gotlaufs/rtu-nixie-clock/Pics/izstade_skola_2018.jpg

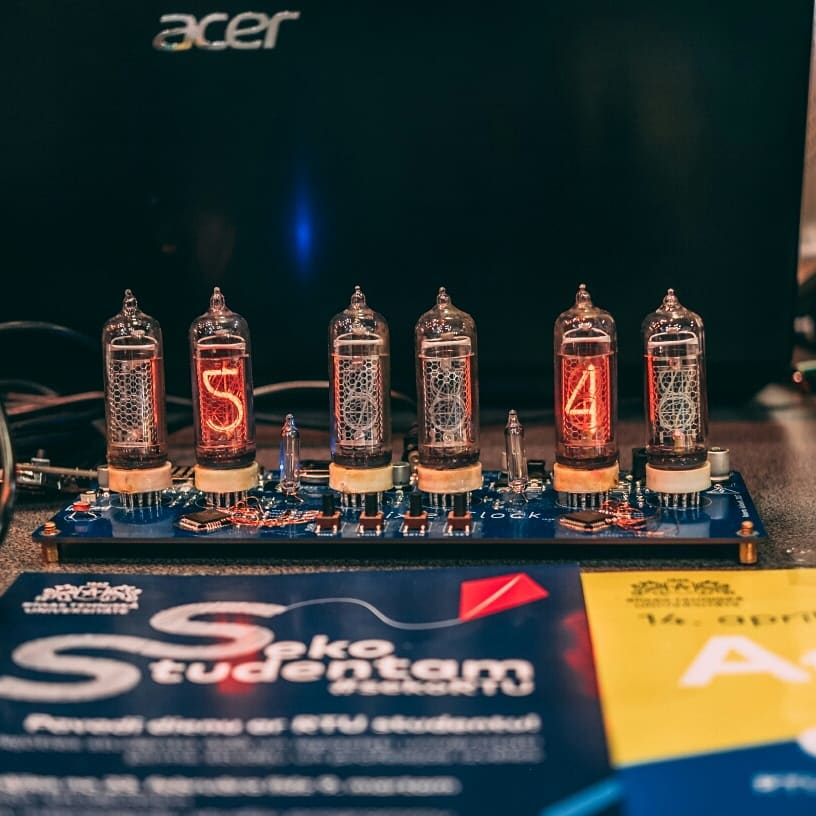
Pics/izstade_skola_2018.jpg
