gotlaufs/rtu-nixie-clock/Software/old/README

This was made using bare ESP8266 NONOS SDK and custom makefile.
