gotlaufs/rtu-nixie-clock/PCB/datasheets/SW_SMD.png

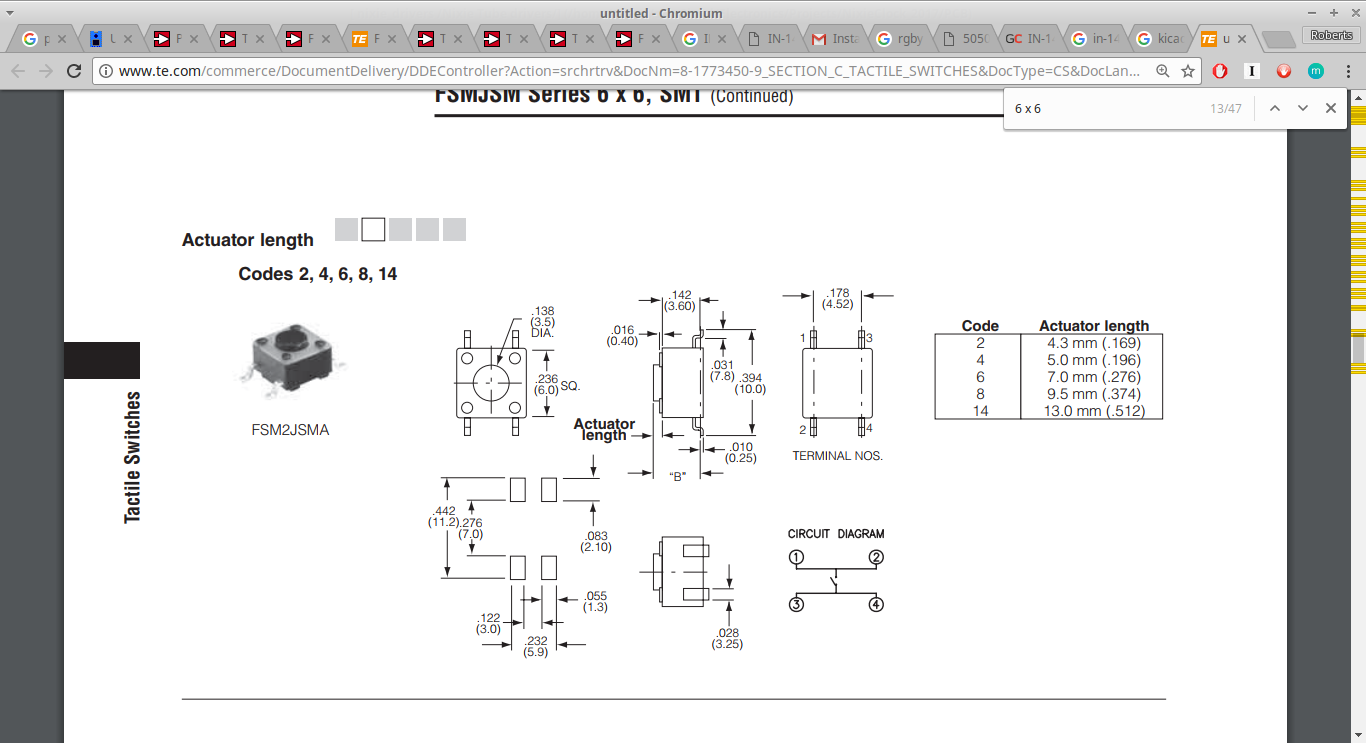
PCB/datasheets/SW_SMD.png
