gotlaufs/rtu-nixie-clock/PCB/datasheets/SW_SMD_2.jpg

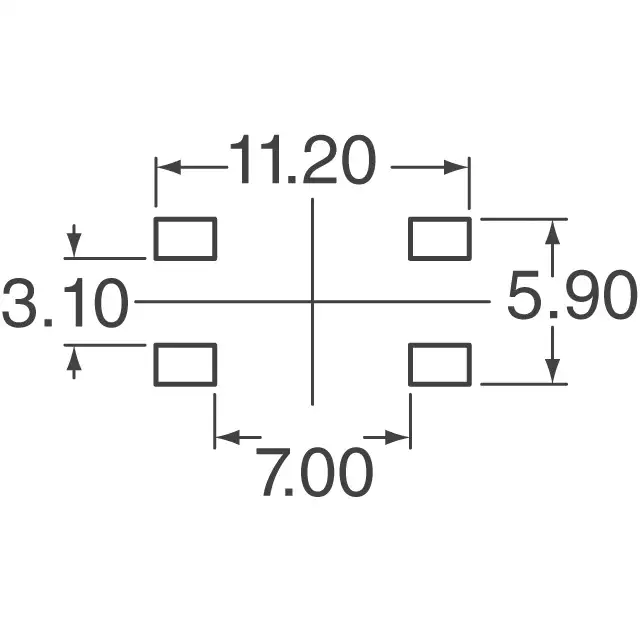
PCB/datasheets/SW_SMD_2.jpg
