gotlaufs/rtu-nixie-clock/Pics/layout/Layout_Before_GND_stiching.png

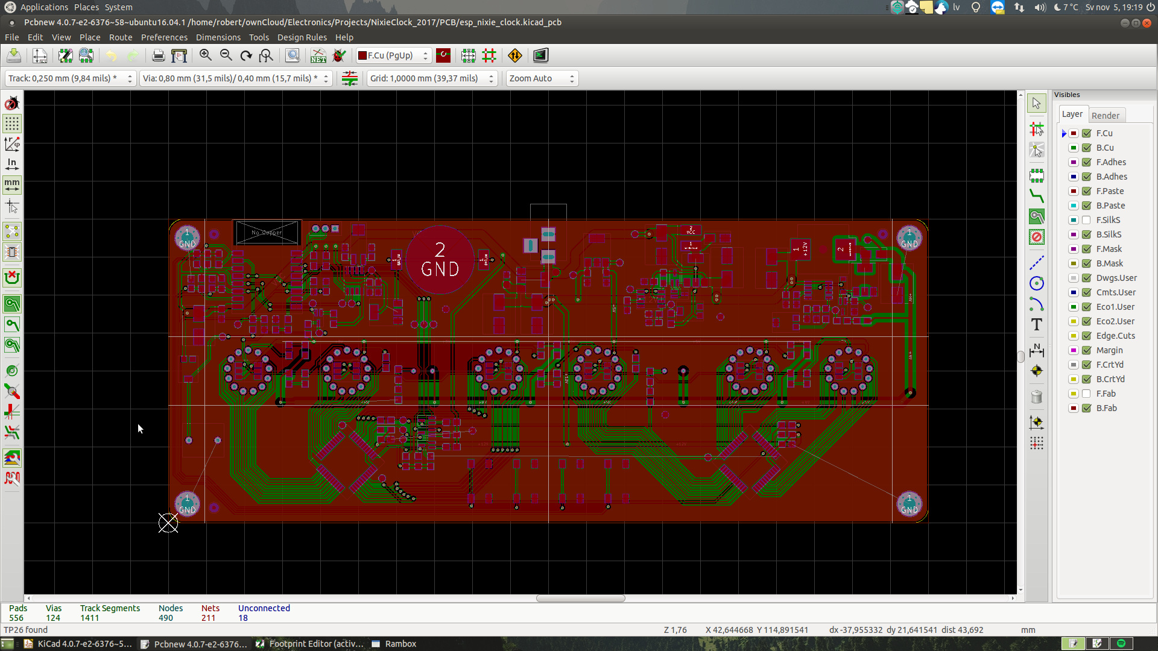
Pics/layout/Layout_Before_GND_stiching.png
