gotlaufs/rtu-nixie-clock/Pics/layout/Routing_PinSwapping_fixed.png

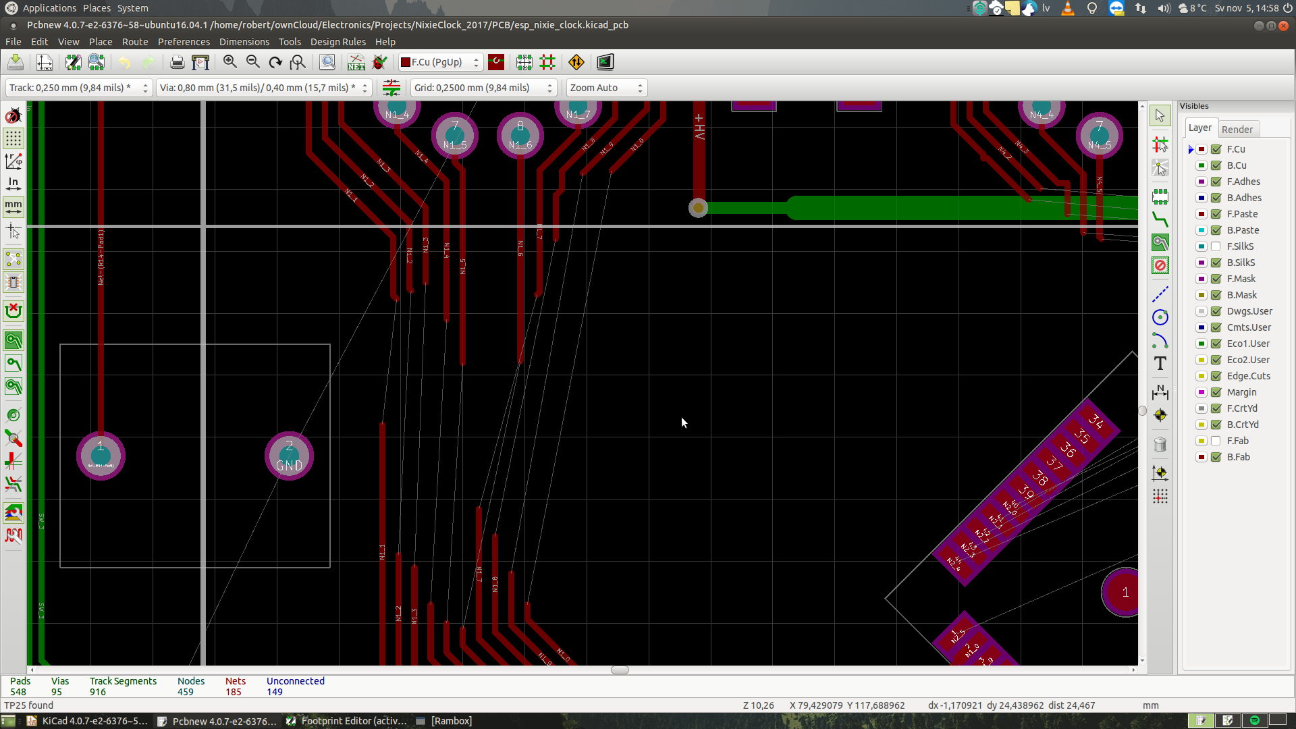
Pics/layout/Routing_PinSwapping_fixed.png
