gotlaufs/rtu-nixie-clock/Pics/layout/Routing_PinSwapping_PCB.png

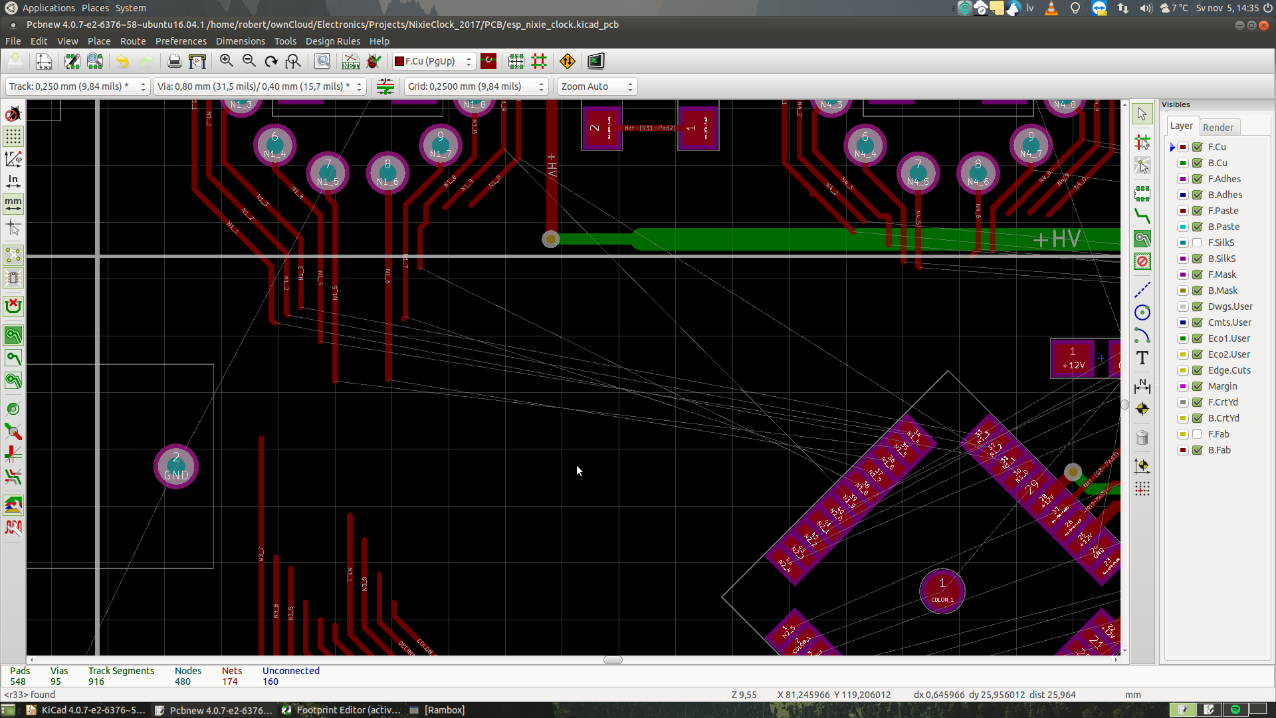
Pics/layout/Routing_PinSwapping_PCB.png
