gotlaufs/rtu-nixie-clock/Pics/layout/Routing_PinSwapping_Schematic.png

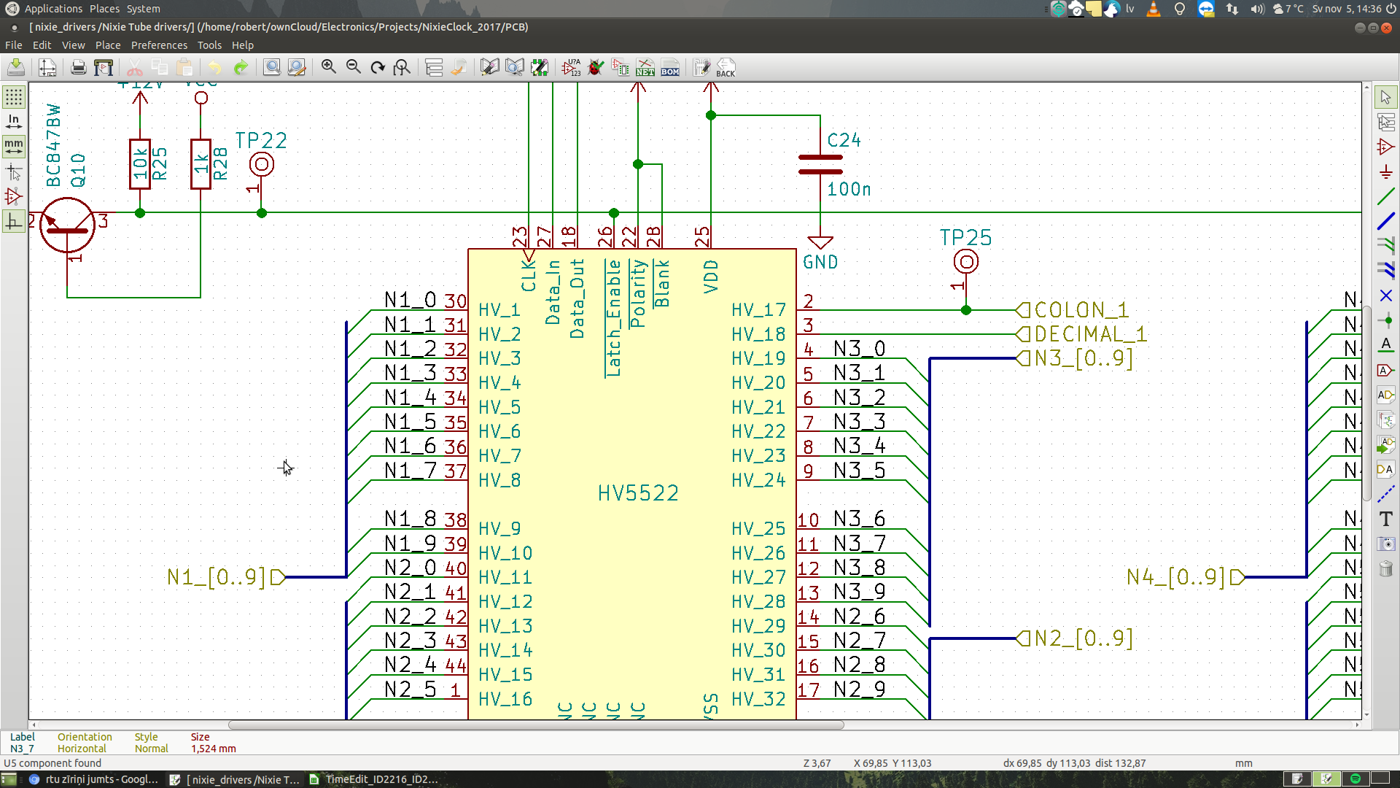
Pics/layout/Routing_PinSwapping_Schematic.png
