gotlaufs/rtu-nixie-clock/Order_2017_11_21.ods

Project | Part description | Name | Digi-key part number | Quantity | Notes
kZPD | Triac | L4004L5TP | F7224-ND | 2
 | Triac driver | MOC3021S | 160-1375-5-ND | 2
 | Optocoupler | H11AA1SM | H11AA1SM-ND | 2
 | Resistor | Res 2010 7.5k | RHM7.5KBGCT-ND | 10
 | Female header | Preci-Dip 310-87-110-41-001101 | 1212-1099-ND | 10
 | PC cable socket | Qualtek 703W-00/04 | Q212-ND | 2
 | MSP430 | MSP430G2230 | 296-30235-1-ND | 2
LED_SB | MSP430 | MSP430G2553 | 296-28430-1-ND | 2
 | Rotary Encoder | Bourns Inc. PEC11R-4225F-S0024 | PEC11R-4225F-S0024-ND | 8
NCK | HV serial to parallel converter | HV5522 | Mouser: 689-HV5522PG-G | 2 | Mouser catalog
 | 5V LDO | AZ1117-5.0 | AZ1117IH-5.0TRG1DICT-ND | 5
 | RTC | MCP7940 RTC | MCP7940NT-I/SNCT-ND | 5
 | Switching voltage regulator | MC34063 | MC34063ADGOS-ND | 5
 | Inductor | L 120 uH | SRN6045TA-121M | 1
 | Crystal | Y 32.768 kHz | CMR200T32768DZBT | 5
 | Power Jack | Power Jack | CP-002B-ND | 1
 | Neon Lamp | A1A | A1A-ND | 4
 | Tactile switch | FSMJSMA | 450-2047-1-ND | 4
 | Trimmer pot | 100k | 987-1013-1-ND | 3
 | Rectifier diode | RS1GTR | 1655-1500-1-ND | 1
 | Rectifier Diode | SS13 R3G | SS13 R3GCT-ND | 1
 | PMOS | NTF5P03T3G | NTF5P03T3GOSCT-ND | 3
 | NMOS | IPN70R900P7SATMA1 | IPN70R900P7SATMA1CT-ND | 1
 | Battery Holder | Linx Technologies Inc. BAT-HLD-001 | BAT-HLD-001-ND | 1
 | Photo resistor | CdS 200k | 1528-2141-ND | 1
 | Cap | 270p | 1276-2494-1-ND | 10
 | Cap | 6p | 1276-1767-1-ND | 10
 | Cap | 680p | 311-1126-1-ND | 10
 | Cap | 10n | 1276-1015-1-ND | 10
 | Cap | 220u | 565-4320-1-ND | 10
 | Resistor | 0R | 311-0.0ARCT-ND | 10
 | Resistor | 5.6k | RMCF0805JT5K60CT-ND | 10
 | Resistor | 3.3k | RMCF0805JT3K30CT-ND | 10
 | Resistor | 10k | RMCF0805JT10K0CT-ND | 20
 | Resistor | 165k | 311-165KCRCT-ND | 10
 | Resistor | 300R | RMCF0805JT300RCT-ND | 10
 | Resistor | 330k | RMCF0805JT330KCT-ND | 10
 | Resistor | 100k | RMCF0805JT100KCT-ND | 10
 | Resistor | 5k | RMCF0805JT5K10CT-ND | 20
 | Resistor | 68k | RMCF0805JT68K0CT-ND | 10
