gotlaufs/rtu-nixie-clock/(threads)

Thread 5 (2019-02-19):

External RTC IC crystal oscillator must be trimmed

gotlaufs, 2019-02-19:
Currently it is a bit too fast and the clock gains a few seconds every hour.
