gotlaufs/rtu-nixie-clock/Documents/nixie_schema.pdf

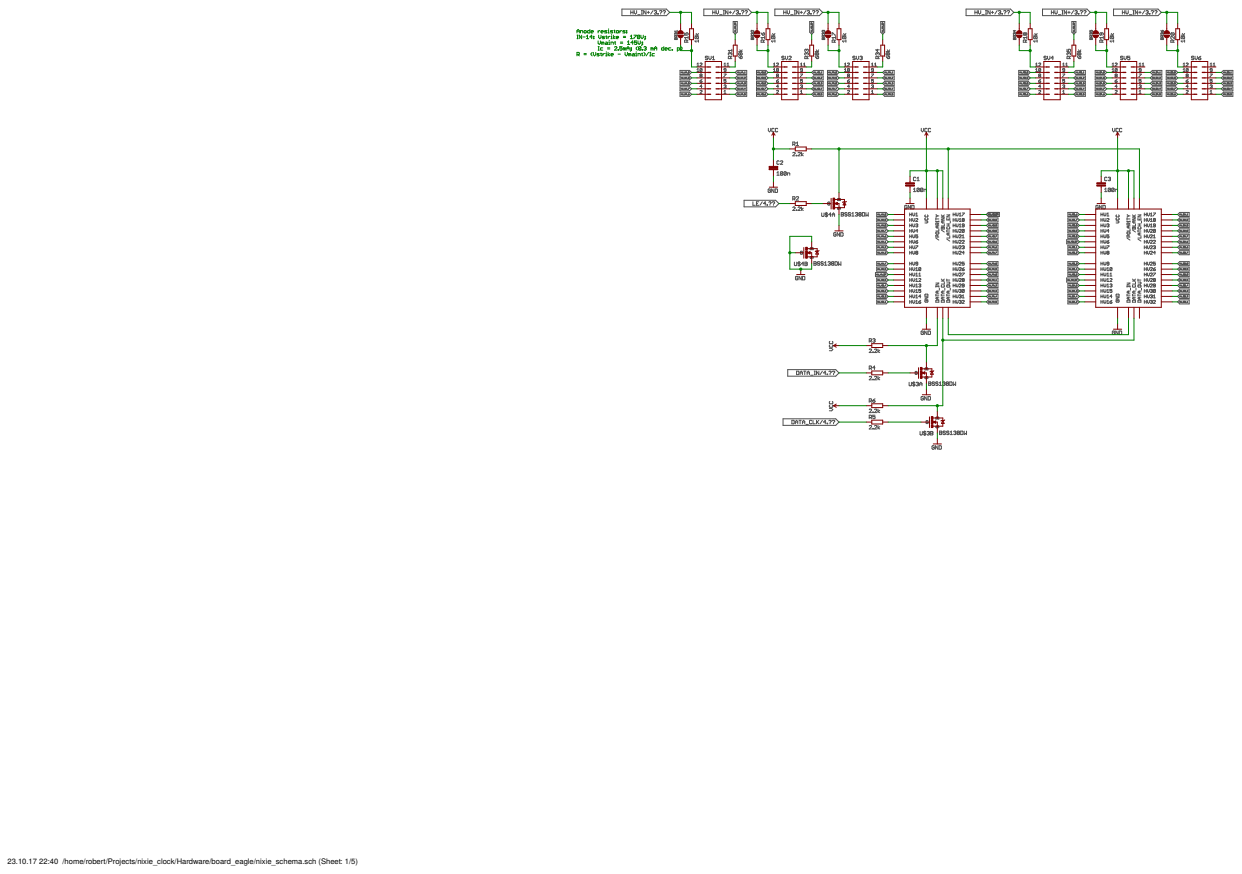
[picture p19: page 1]

23.10.17 22:40 /home/robert/Projects/nixie_clock/Hardware/board_eagle/nixie_schema.sch (Sheet: 1/5)

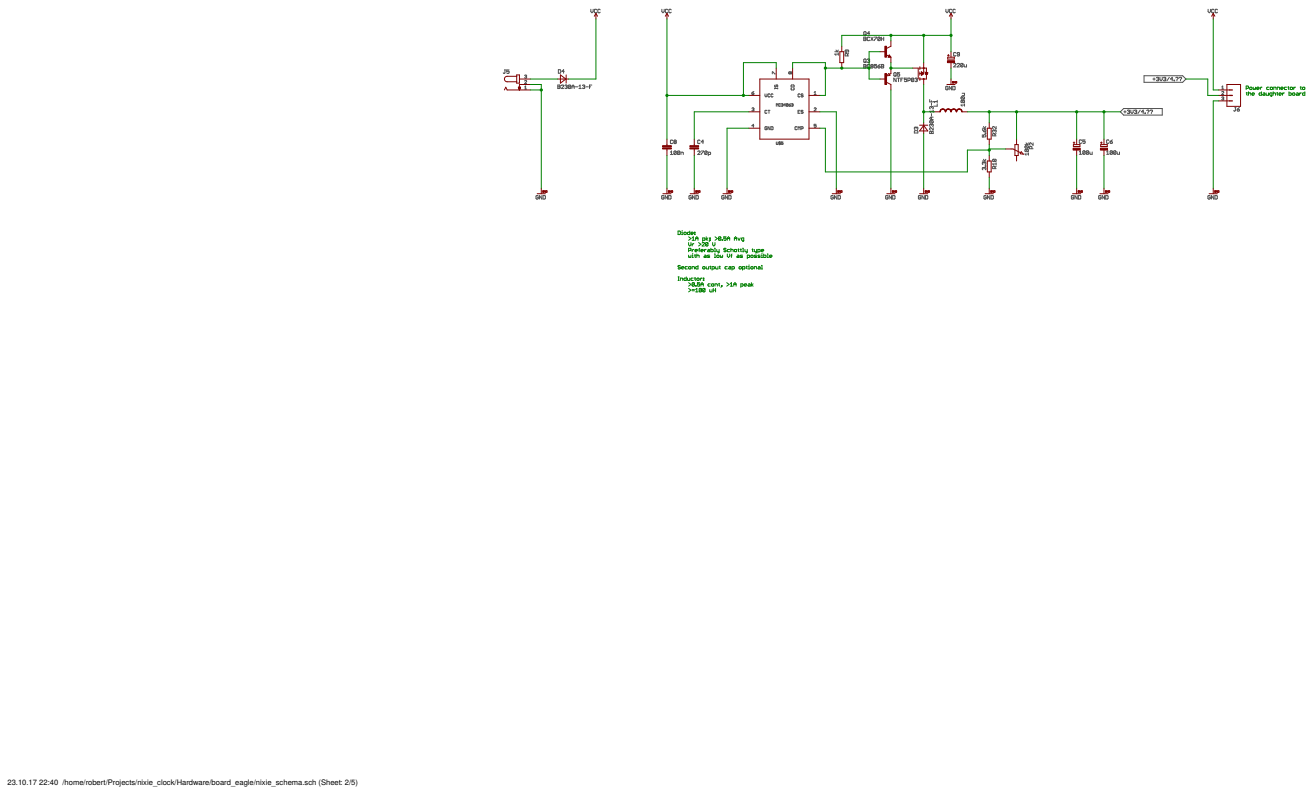
[picture p20: page 2]

23.10.17 22:40 /home/robert/Projects/nixie_clock/Hardware/board_eagle/nixie_schema.sch (Sheet: 2/5)

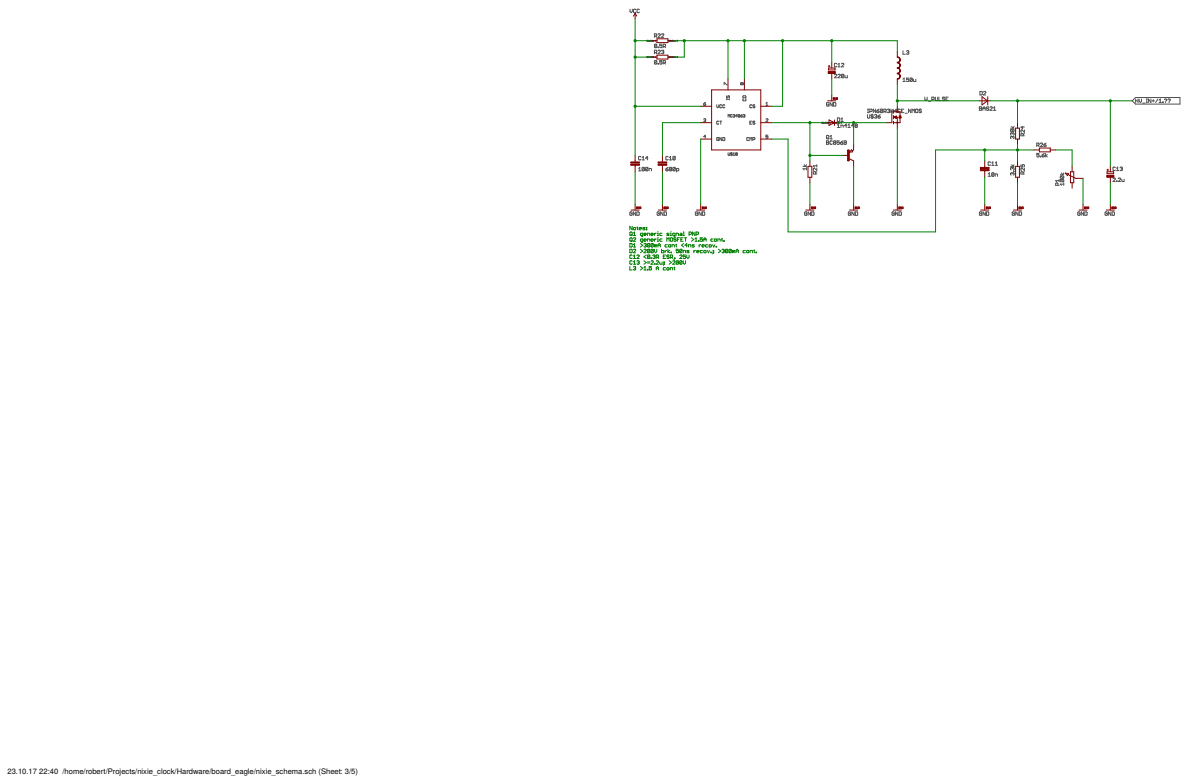
[picture p21: page 3]

23.10.17 22:40 /home/robert/Projects/nixie_clock/Hardware/board_eagle/nixie_schema.sch (Sheet: 3/5)

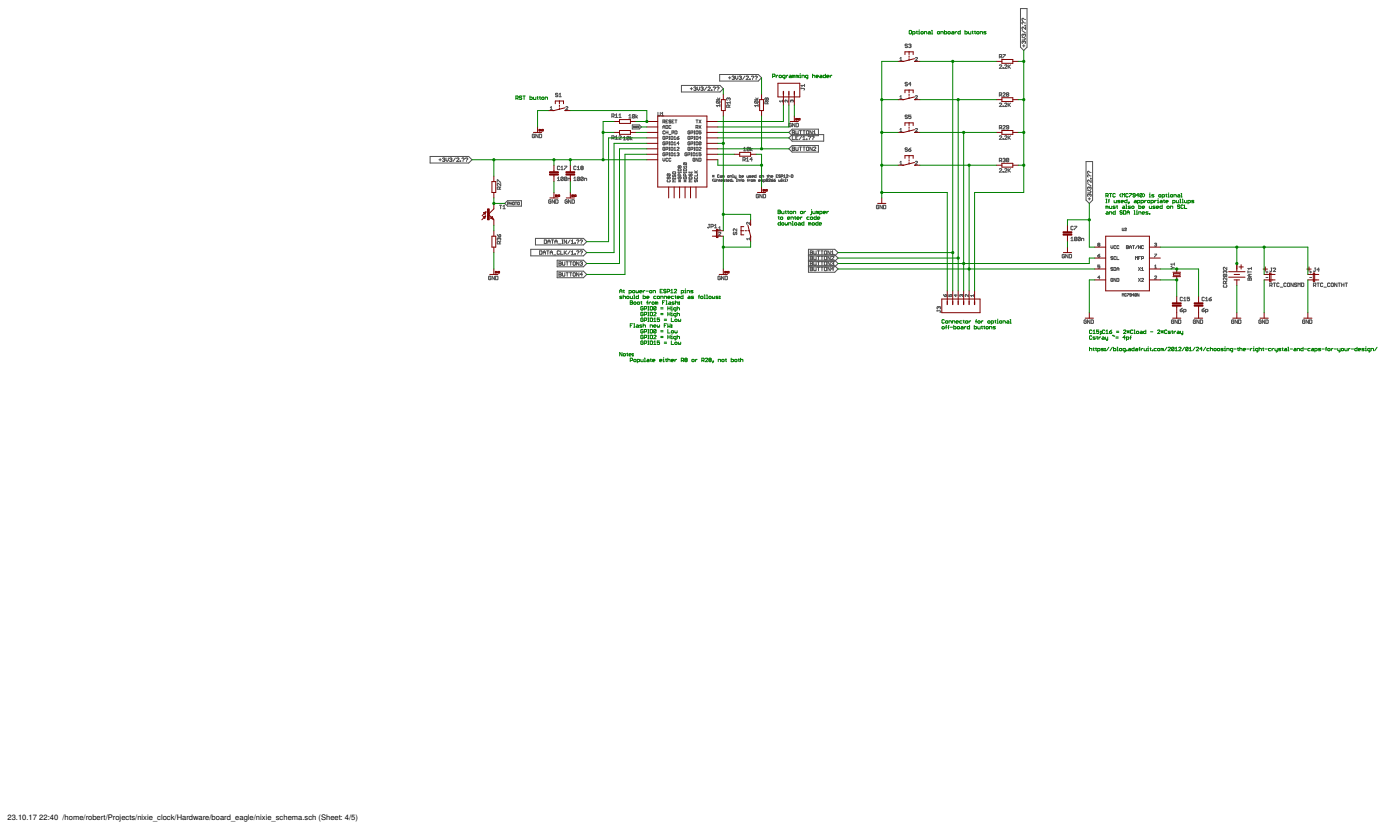
[picture p22: page 4]

23.10.17 22:40 /home/robert/Projects/nixie_clock/Hardware/board_eagle/nixie_schema.sch (Sheet: 4/5)

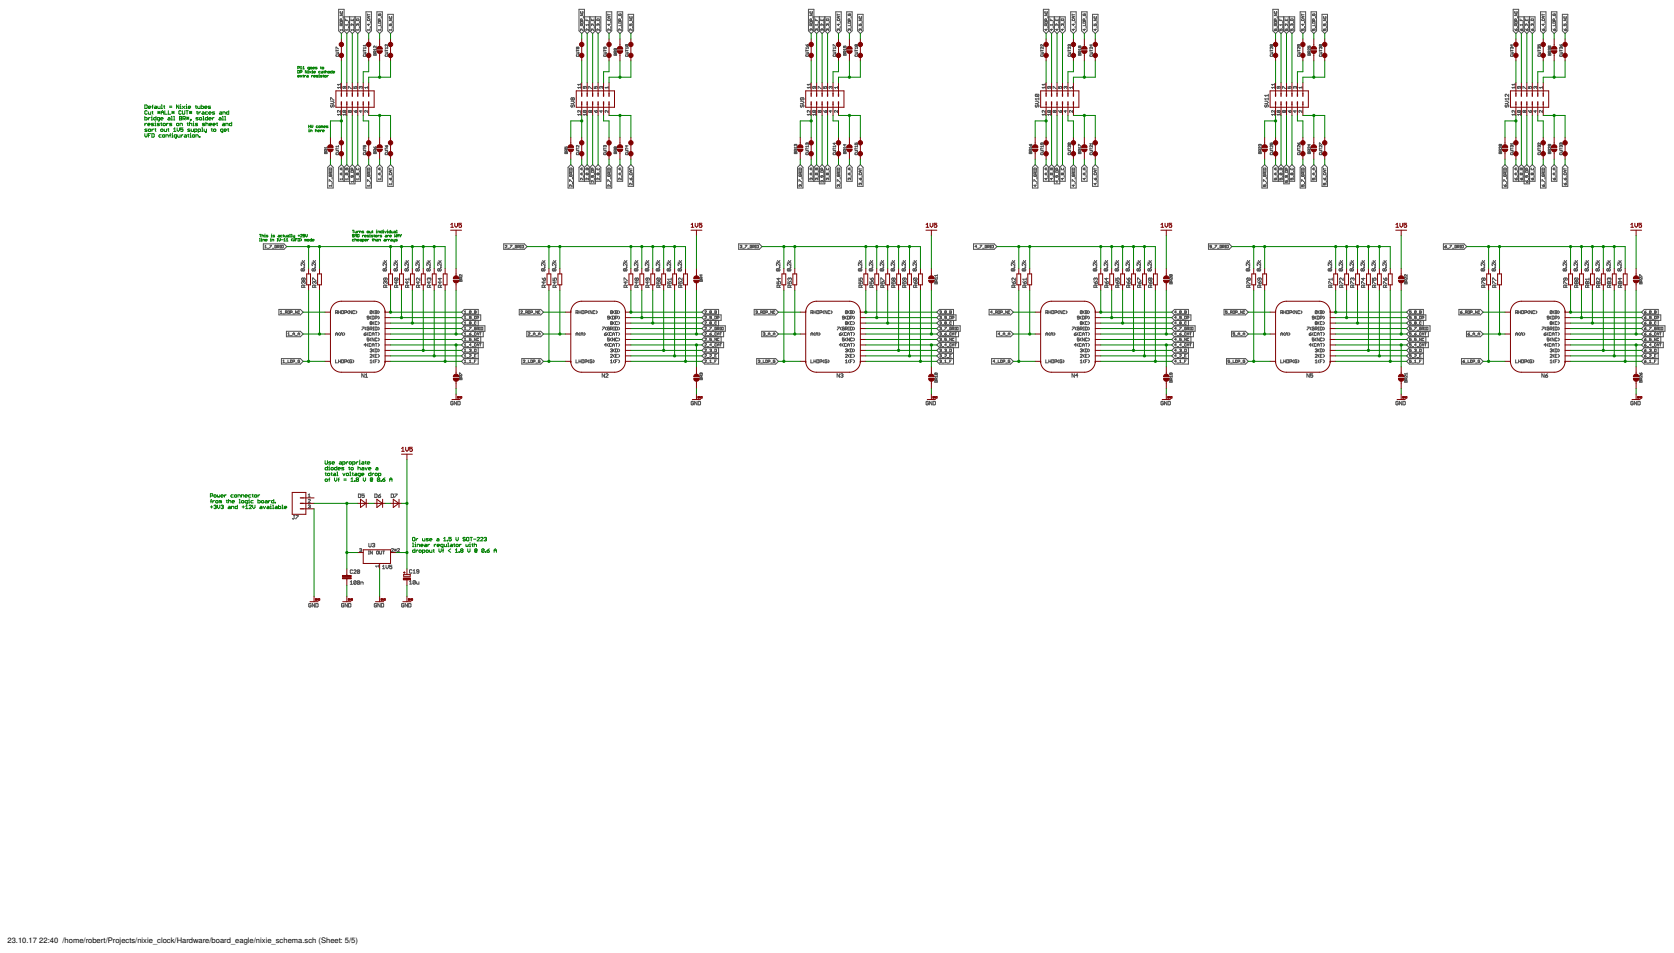
[picture p23: page 5]

23.10.17 22:40 /home/robert/Projects/nixie_clock/Hardware/board_eagle/nixie_schema.sch (Sheet: 5/5)
