gotlaufs/rtu-nixie-clock/PCB/PDF/esp_nixie_clock.pdf

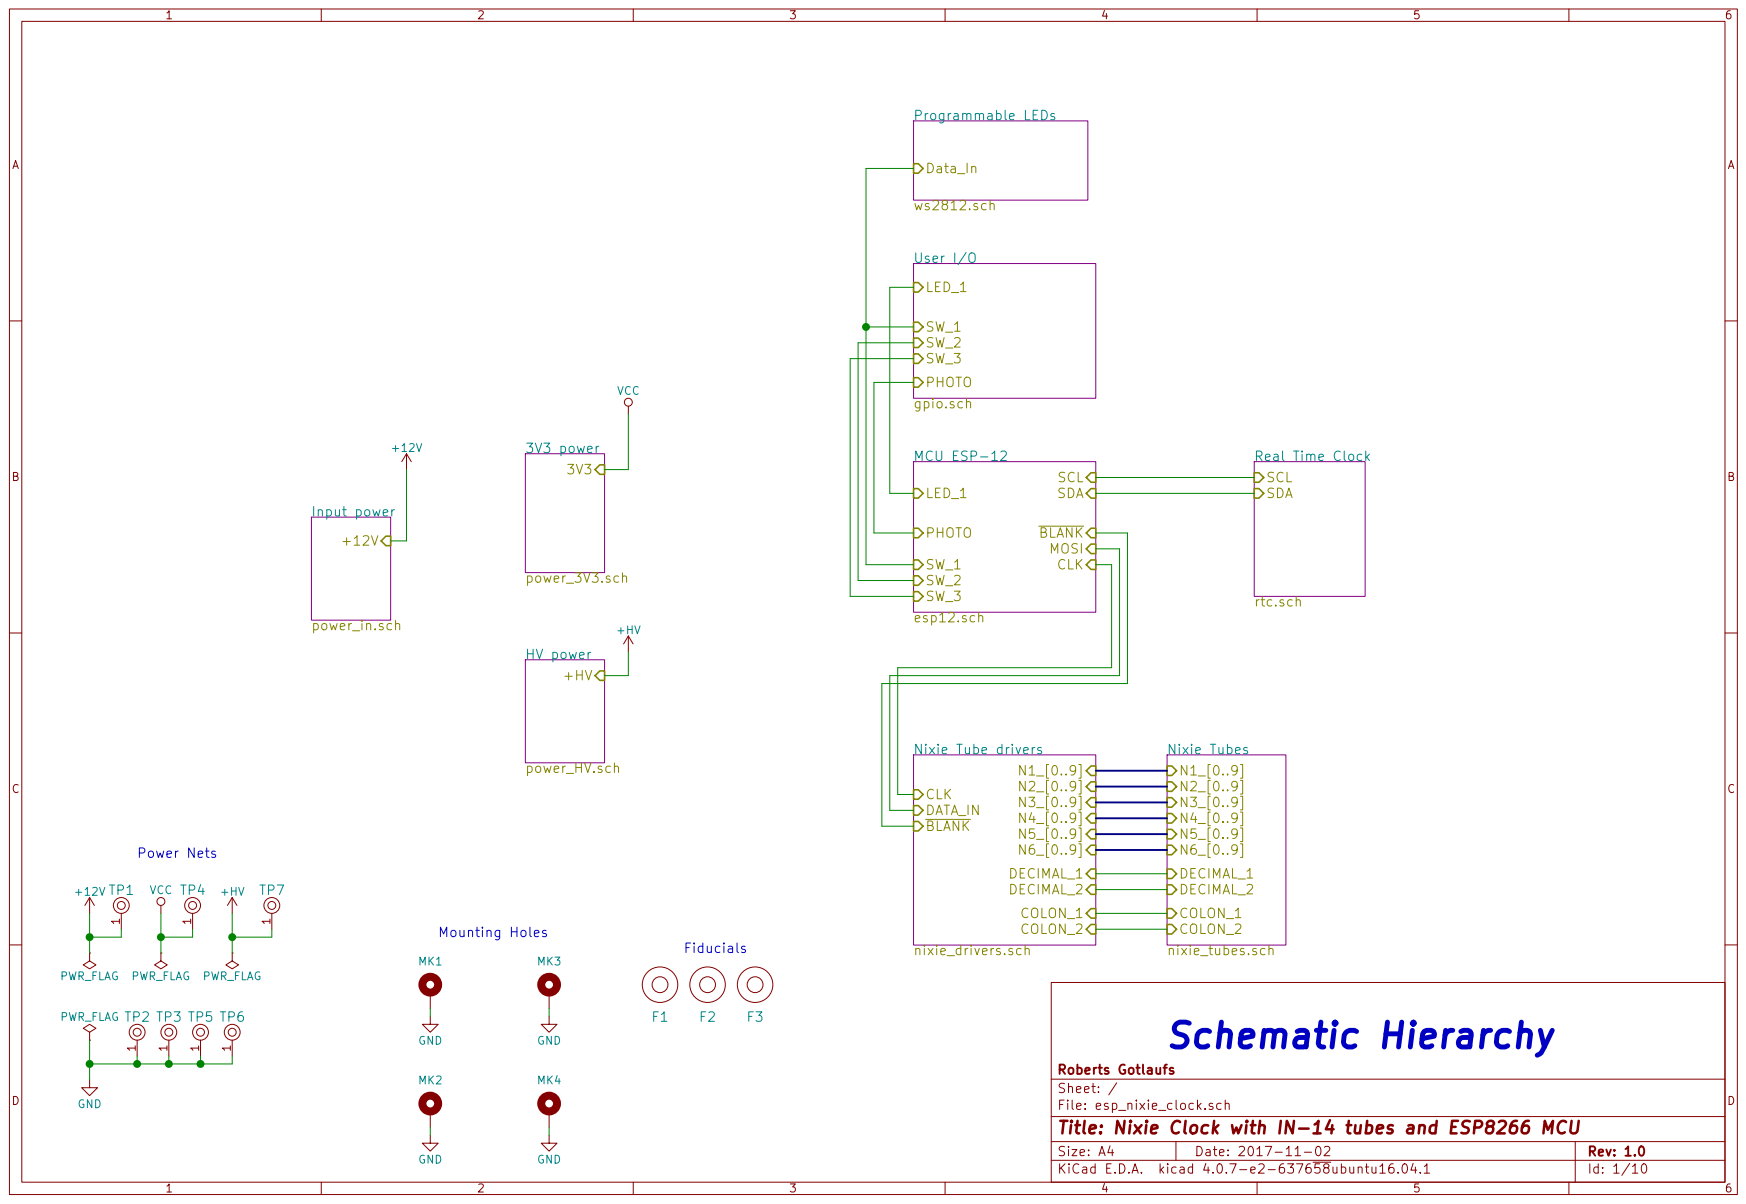
[picture p24: page 1]

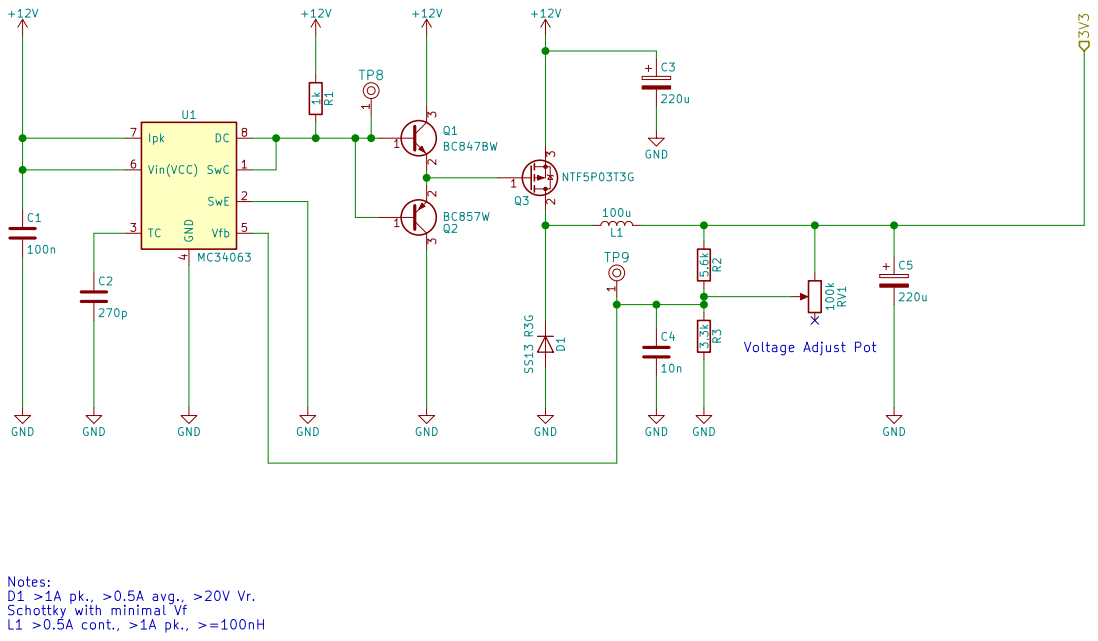
[picture p25: page 2]

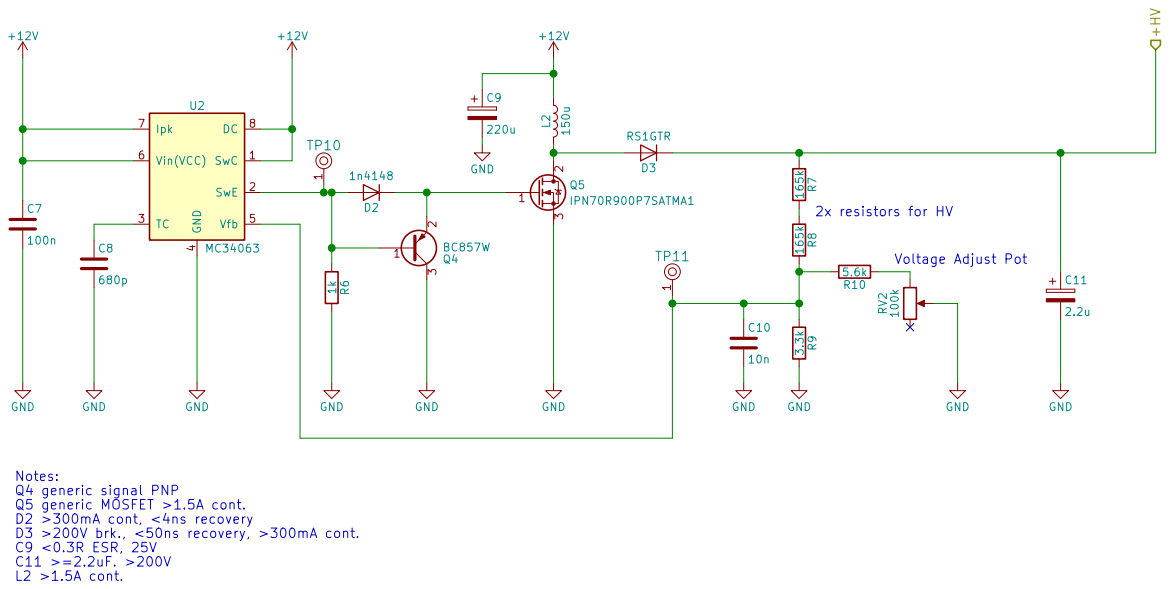
[picture p26: page 3]

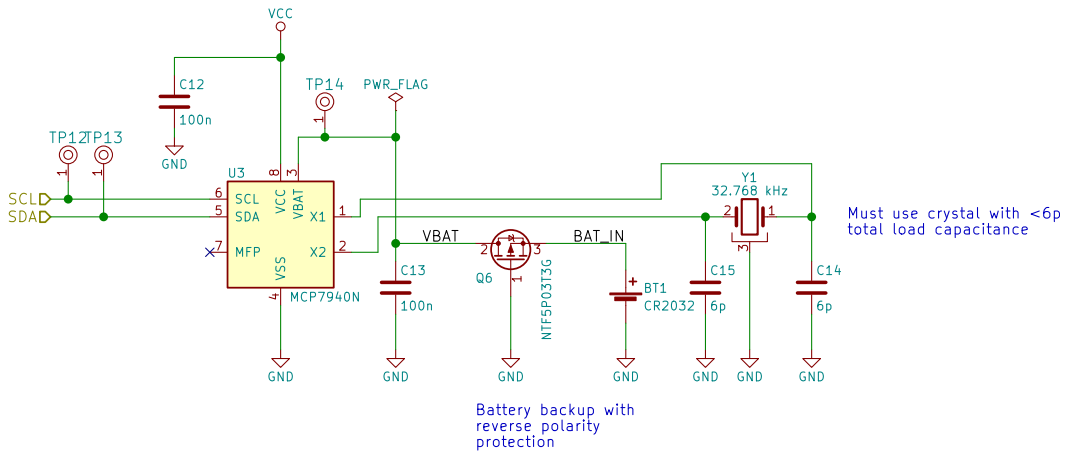
[picture p27: page 4]

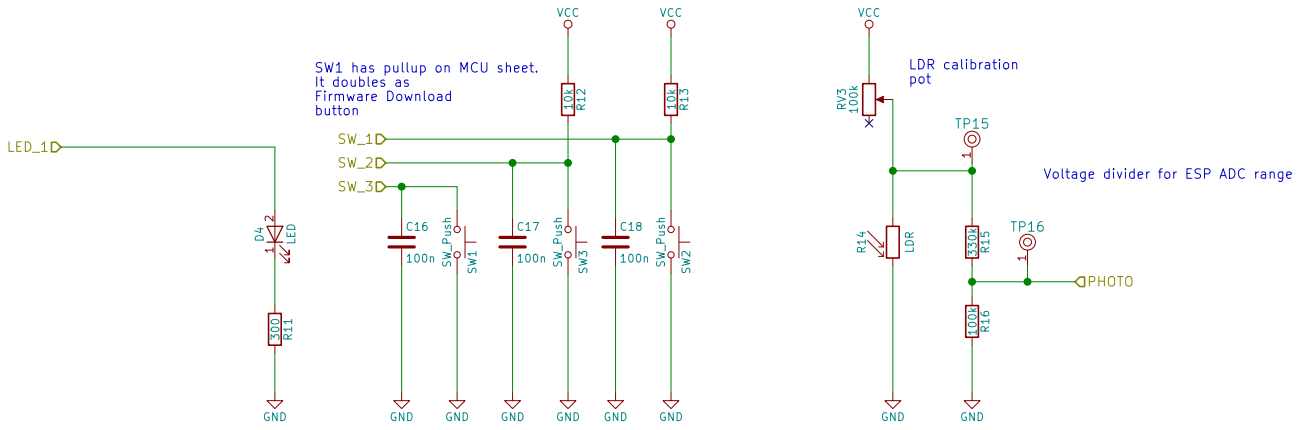
[picture p28: page 5]

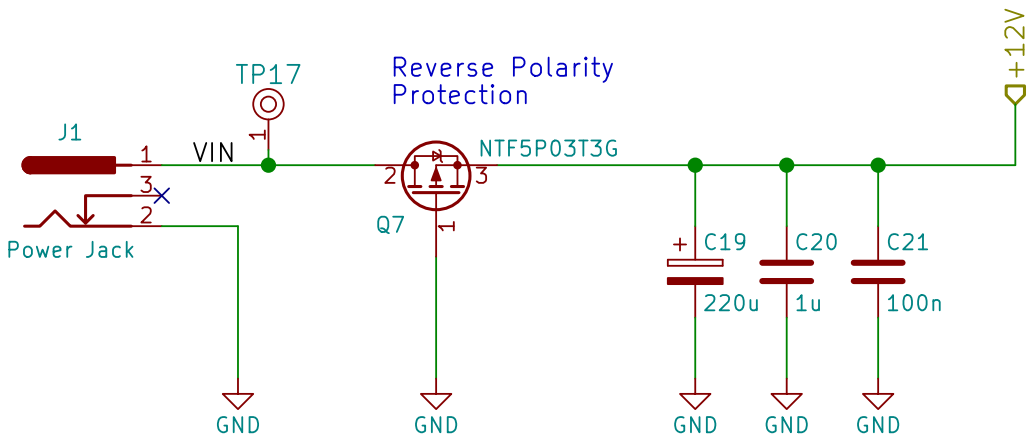
[picture p29: page 6]

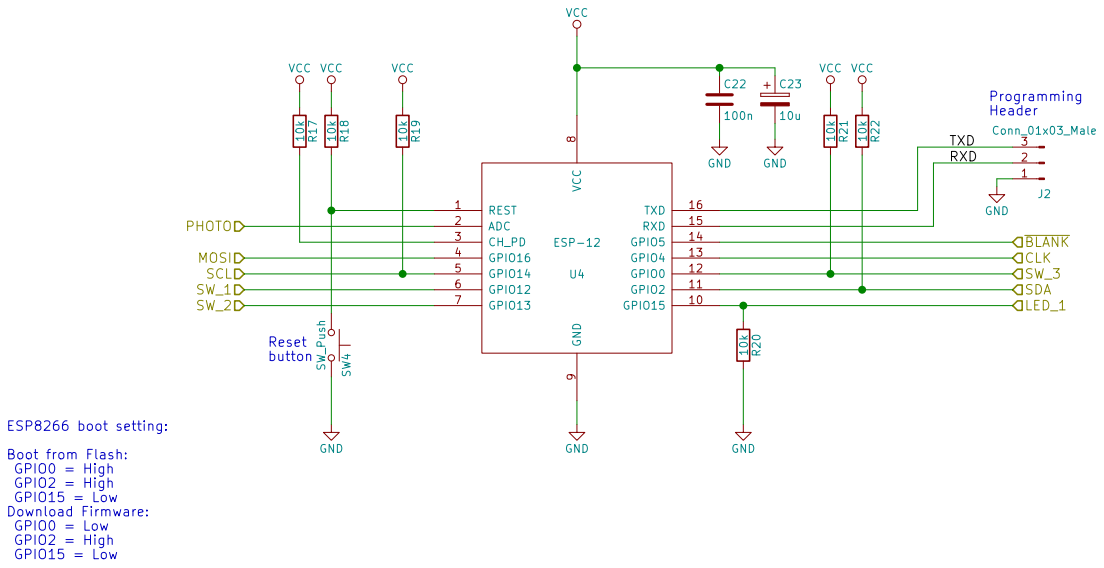
[picture p30: page 7]

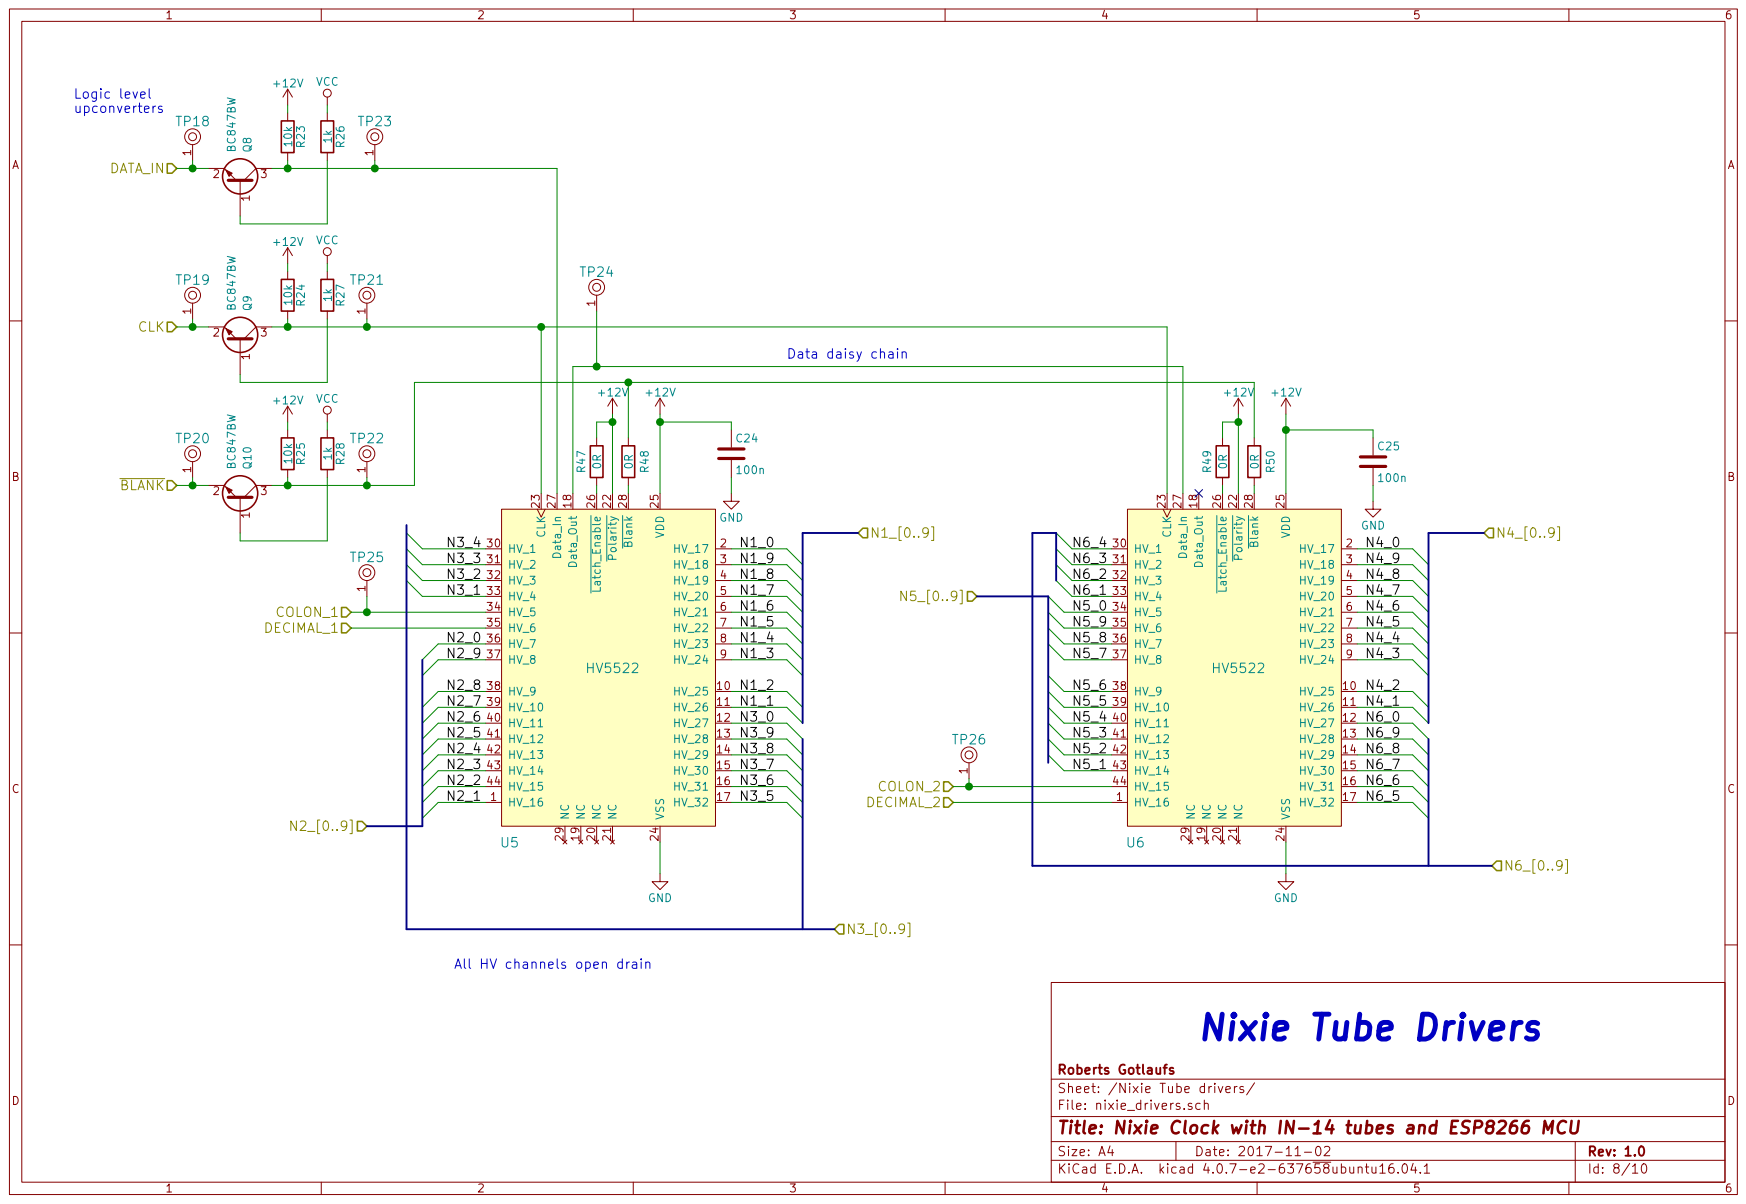
[picture p31: page 8]

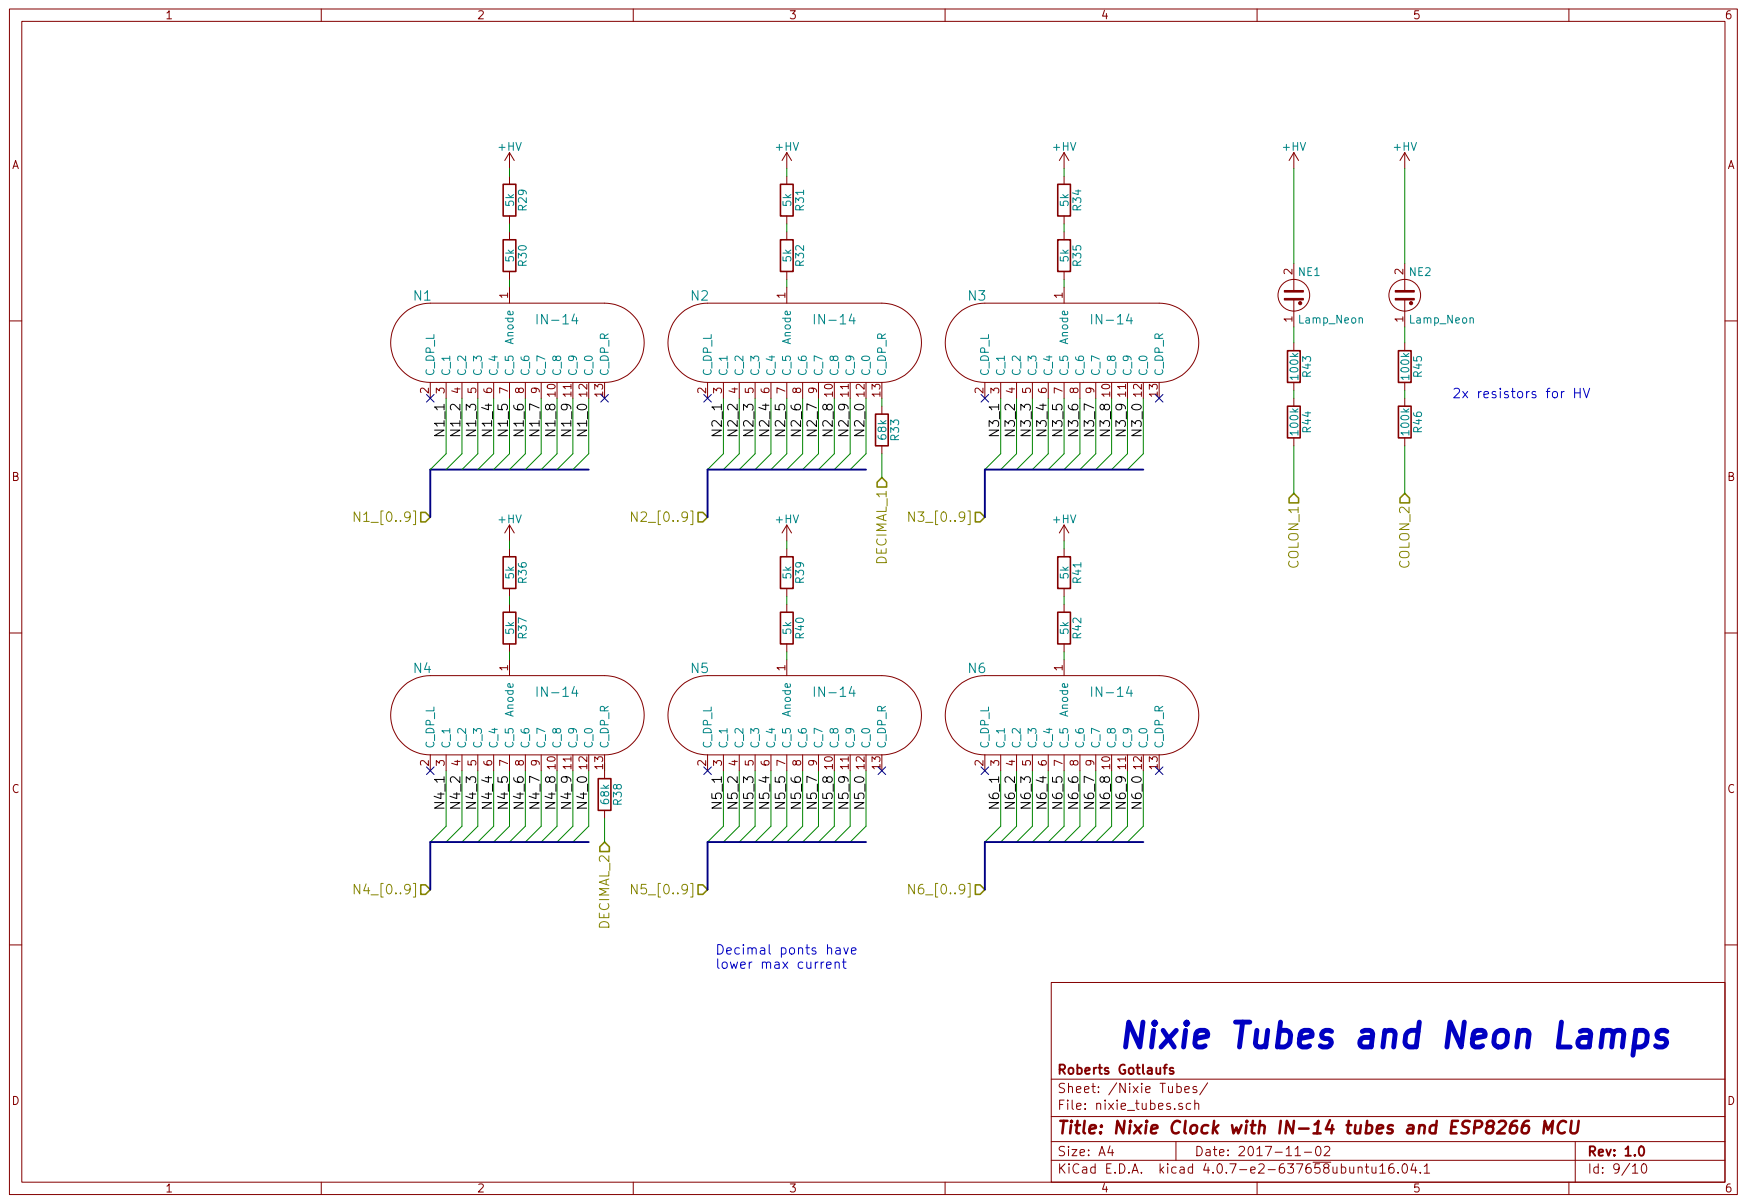
[picture p32: page 9]

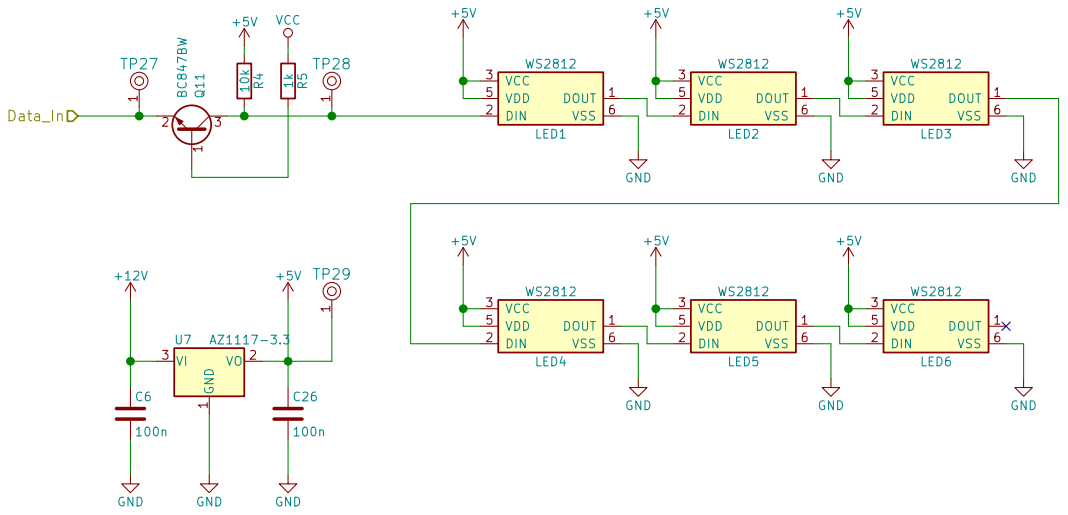
[picture p33: page 10]
