gotlaufs/rtu-nixie-clock/Simulations/LTSpice/Draft1.asc

Q1: npn; 2N2222
R1: res; 10k
R2: res; 10k
R3: res; 10k
R4: res; 1Meg
V1: voltage; 3.3
V2: voltage; 5
V3: voltage; PULSE(5 0 100m 1m 1m 100m)
Named nets: 0, 3V3, 5V, Vin, Vout
.tran 300m
