gotlaufs/rtu-nixie-clock/Simulations/LTSpice/Noninverting_level_shift.asc

M1: nmos; Si7540DP_N
Q1: npn
R1: res; 10k
R2: res; 1k
R3: res; 10k
R4: res; 1k
V1: voltage; PULSE(0 3.3 10u 0.1u 0.1u 20u 50u)
V2: voltage; 12
V3: voltage; 3.3
Named nets: 0, 12V, Vout, Vin, 3V3, Vout_mos
.tran 1m
Don't use MOSFET in this configuration
This is OK
