gotlaufs/rtu-nixie-clock/PCB/esp_nixie_clock.kicad_pcb

## KiCad design PCB/esp_nixie_clock.kicad_pcb (2019-01-02)

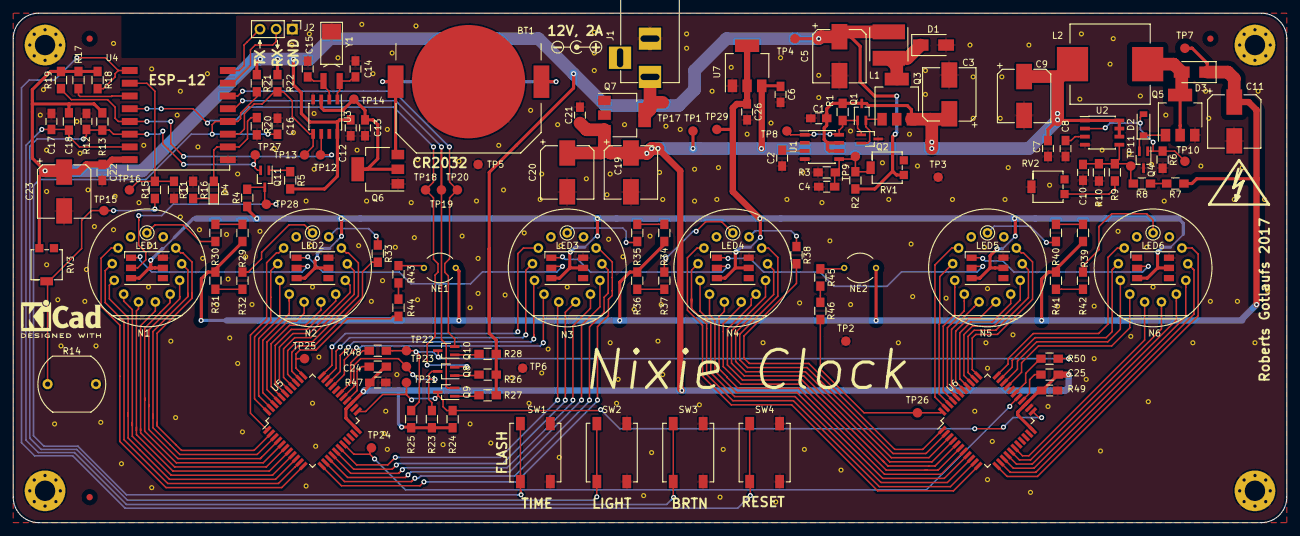
[picture p34: board esp_nixie_clock.kicad_pcb from above]

Board: 2 copper layers, 200.0 x 80.0 mm, 161 parts (0 on the bottom side), 138 nets.

Parts:
BT1: CR2032; BATT_HOLDER
C1, C6, C7, C12, C13, C16, C17, C18, C21, C22, C24, C25, C26: 100n; C_0805_HandSoldering
C2: 270p; C_0805_HandSoldering
C3, C5, C9, C19: 220u; CP_Elec_8x10
C4, C10: 10n; C_0805_HandSoldering
C8: 680p; C_0805_HandSoldering
C11: 2.2u; CP_Elec_8x10
C14, C15: 6p; C_0805_HandSoldering
C20: 1u; CP_Elec_8x10
C23: 10u; CP_Elec_8x10
D1: SS13 R3G; D_SMA
D2: 1n4148; D_SOD-123
D3: RS1GTR; D_SMA
D4: LED; LED_0805_HandSoldering
F1, F2, F3: Fiducial; Fiducial_1mm_Dia_2.54mm_Outer_CopperTop
J1: Power Jack; BARREL_JACK
J2: Conn_01x03_Male; Pin_Header_Straight_1x03_Pitch2.54mm
L1: 100u; L_100u
L2: 150u; L_Wuerth_WE-PD-Typ-LS_Handsoldering
LED1, LED2, LED3, LED4, LED5, LED6: WS2812; LED_WS2812-PLCC6
MK1, MK2, MK3, MK4: Mounting_Hole_PAD; MountingHole_3.2mm_M3_Pad_Via
N1, N2, N3, N4, N5, N6: IN-14
NE1, NE2: Lamp_Neon; NE-2
Q1, Q8, Q9, Q10, Q11: BC847BW; SOT-323_SC-70_Handsoldering
Q2, Q4: BC857W; SOT-323_SC-70_Handsoldering
Q3, Q6, Q7: NTF5P03T3G; SOT-223-3_TabPin2
Q5: IPN70R900P7SATMA1; SOT-223-3_TabPin2
R1, R5, R6, R26, R27, R28: 1k; R_0805_HandSoldering
R2, R10: 5.6k; R_0805_HandSoldering
R3, R9: 3.3k; R_0805_HandSoldering
R4, R12, R13, R17, R18, R19, R20, R21, R22, R23, R24, R25: 10k; R_0805_HandSoldering
R7, R8: 165k; R_0805_HandSoldering
R11: 300; R_0805_HandSoldering
R14: LDR; Resistor_LDR_10x8.5_RM7.6
R15: 330k; R_0805_HandSoldering
R16, R43, R44, R45, R46: 100k; R_0805_HandSoldering
R29, R30, R31, R32, R34, R35, R36, R37, R39, R40, R41, R42: 5k; R_0805_HandSoldering
R33, R38: 68k; R_0805_HandSoldering
R47, R48, R49, R50: 0R; R_0805_HandSoldering
RV1, RV2, RV3: 100k; Potentiometer_Trimmer_Bourns_3214G
SW1, SW2, SW3, SW4: SW_Push; SW_SMD
TP1, TP2, TP3, TP4, TP5, TP6, TP7, TP8, TP9, TP10, TP11, TP12, TP13, TP14, TP15, TP16, TP17, TP18, TP19, TP20, TP21, TP22, TP23, TP24, TP25, TP26, TP27, TP28, TP29: TestPoint; Measurement_Point_Round-SMD-Pad_Small
U1, U2: MC34063; SOIC-8_3.9x4.9mm_Pitch1.27mm
U3: MCP7940N; SOIC-8_3.9x4.9mm_Pitch1.27mm
U4: ESP-12; ESP-12-SMD
U5, U6: HV5522; PQFP-44_10x10mm_Pitch0.8mm
U7: AZ1117-3.3; SOT-223-3_TabPin2
Y1: 32.768 kHz; Citizen_CMR200T

Connections:
+5V: C26.1, LED1.3, LED1.5, LED2.3, LED2.5, LED3.3, LED3.5, LED4.3, LED4.5, LED5.3, LED5.5, LED6.3, LED6.5, R4.1, TP29.1, U7.2
+12V: C1.1, C3.1, C6.1, C7.1, C9.1, C19.1, C20.1, C21.1, C24.1, C25.1, L2.1, Q1.3, Q3.3, Q7.3, R1.1, R23.1, R24.1, R25.1, R47.1, R49.1, TP1.1, U1.6, U1.7, U2.1, U2.6, U2.7, U2.8, U5.22, U5.25, U6.22, U6.25, U7.3
+HV: C11.1, D3.1, NE1.2, NE2.2, R7.1, R29.1, R31.1, R34.1, R36.1, R39.1, R41.1, TP7.1
/Input power/VIN: J1.1, Q7.2, TP17.1
/MCU ESP-12/CLK: Q9.2, TP19.1, U4.13
/MCU ESP-12/LED_1: D4.2, R20.1, U4.10
/MCU ESP-12/PHOTO: R15.2, R16.1, TP16.1, U4.2
/MCU ESP-12/RXD: J2.2, U4.15
/MCU ESP-12/SCL: R19.2, TP12.1, U3.6, U4.5
/MCU ESP-12/SDA: R22.2, TP13.1, U3.5, U4.11
/MCU ESP-12/SW_2: C17.1, R12.2, SW3.1, U4.7
/MCU ESP-12/SW_3: C16.1, R21.2, SW1.1, U4.12
/MCU ESP-12/TXD: J2.3, U4.16
/MCU ESP-12/~BLANK: Q10.2, TP20.1, U4.14
/Nixie Tube drivers/COLON_1: R44.2, TP25.1, U5.34
/Nixie Tube drivers/COLON_2: R46.2, TP26.1, U6.44
/Nixie Tube drivers/DATA_IN: Q8.2, TP18.1, U4.4
/Nixie Tube drivers/DECIMAL_1: R33.2, U5.35
/Nixie Tube drivers/DECIMAL_2: R38.2, U6.1
/Nixie Tube drivers/N1_0: N1.12, U5.2
/Nixie Tube drivers/N1_1: N1.3, U5.11
/Nixie Tube drivers/N1_2: N1.4, U5.10
/Nixie Tube drivers/N1_3: N1.5, U5.9
/Nixie Tube drivers/N1_4: N1.6, U5.8
/Nixie Tube drivers/N1_5: N1.7, U5.7
/Nixie Tube drivers/N1_6: N1.8, U5.6
/Nixie Tube drivers/N1_7: N1.9, U5.5
/Nixie Tube drivers/N1_8: N1.10, U5.4
/Nixie Tube drivers/N1_9: N1.11, U5.3
/Nixie Tube drivers/N2_0: N2.12, U5.36
/Nixie Tube drivers/N2_1: N2.3, U5.1
/Nixie Tube drivers/N2_2: N2.4, U5.44
/Nixie Tube drivers/N2_3: N2.5, U5.43
/Nixie Tube drivers/N2_4: N2.6, U5.42
/Nixie Tube drivers/N2_5: N2.7, U5.41
/Nixie Tube drivers/N2_6: N2.8, U5.40
/Nixie Tube drivers/N2_7: N2.9, U5.39
/Nixie Tube drivers/N2_8: N2.10, U5.38
/Nixie Tube drivers/N2_9: N2.11, U5.37
/Nixie Tube drivers/N3_0: N3.12, U5.12
/Nixie Tube drivers/N3_1: N3.3, U5.33
/Nixie Tube drivers/N3_2: N3.4, U5.32
/Nixie Tube drivers/N3_3: N3.5, U5.31
/Nixie Tube drivers/N3_4: N3.6, U5.30
/Nixie Tube drivers/N3_5: N3.7, U5.17
/Nixie Tube drivers/N3_6: N3.8, U5.16
/Nixie Tube drivers/N3_7: N3.9, U5.15
/Nixie Tube drivers/N3_8: N3.10, U5.14
/Nixie Tube drivers/N3_9: N3.11, U5.13
/Nixie Tube drivers/N4_0: N4.12, U6.2
/Nixie Tube drivers/N4_1: N4.3, U6.11
/Nixie Tube drivers/N4_2: N4.4, U6.10
/Nixie Tube drivers/N4_3: N4.5, U6.9
/Nixie Tube drivers/N4_4: N4.6, U6.8
/Nixie Tube drivers/N4_5: N4.7, U6.7
/Nixie Tube drivers/N4_6: N4.8, U6.6
/Nixie Tube drivers/N4_7: N4.9, U6.5
/Nixie Tube drivers/N4_8: N4.10, U6.4
/Nixie Tube drivers/N4_9: N4.11, U6.3
/Nixie Tube drivers/N5_0: N5.12, U6.34
/Nixie Tube drivers/N5_1: N5.3, U6.43
/Nixie Tube drivers/N5_2: N5.4, U6.42
/Nixie Tube drivers/N5_3: N5.5, U6.41
/Nixie Tube drivers/N5_4: N5.6, U6.40
/Nixie Tube drivers/N5_5: N5.7, U6.39
/Nixie Tube drivers/N5_6: N5.8, U6.38
/Nixie Tube drivers/N5_7: N5.9, U6.37
/Nixie Tube drivers/N5_8: N5.10, U6.36
/Nixie Tube drivers/N5_9: N5.11, U6.35
/Nixie Tube drivers/N6_0: N6.12, U6.12
/Nixie Tube drivers/N6_1: N6.3, U6.33
/Nixie Tube drivers/N6_2: N6.4, U6.32
/Nixie Tube drivers/N6_3: N6.5, U6.31
/Nixie Tube drivers/N6_4: N6.6, U6.30
/Nixie Tube drivers/N6_5: N6.7, U6.17
/Nixie Tube drivers/N6_6: N6.8, U6.16
/Nixie Tube drivers/N6_7: N6.9, U6.15
/Nixie Tube drivers/N6_8: N6.10, U6.14
/Nixie Tube drivers/N6_9: N6.11, U6.13
/Programmable LEDs/Data_In: C18.1, Q11.2, R13.2, SW2.1, TP27.1, U4.6
/Real Time Clock/BAT_IN: BT1.1, Q6.3
/Real Time Clock/VBAT: C13.1, Q6.2, TP14.1, U3.3
GND: BT1.2, C1.2, C2.2, C3.2, C4.2, C5.2, C6.2, C7.2, C8.2, C9.2, C10.2, C11.2, C12.2, C13.2, C14.2, C15.2, C16.2, C17.2, C18.2, C19.2, C20.2, C21.2, C22.2, C23.2, C24.2, C25.2, C26.2, D1.2, J1.2, J2.1, LED1.6, LED2.6, LED3.6, LED4.6, LED5.6, LED6.6, MK1.1, MK2.1, MK3.1, MK4.1, Q2.3, Q4.3, Q5.3, Q6.1, Q7.1, R3.2, R6.2, R9.2, R11.2, R14.2, R16.2, R20.2, RV2.2, SW1.2, SW2.2, SW3.2, SW4.2, TP2.1, TP3.1, TP5.1, TP6.1, U1.2, U1.4, U2.4, U3.4, U4.9, U5.24, U6.24, U7.1, Y1.3
unnamed: C2.1, U1.3
unnamed: C4.1, R2.2, R3.1, RV1.2, TP9.1, U1.5
unnamed: C8.1, U2.3
unnamed: C10.1, R8.2, R9.1, R10.2, TP11.1, U2.5
unnamed: C14.1, U3.1, Y1.1
unnamed: C15.1, U3.2, Y1.2
unnamed: D1.1, L1.1, Q3.2
unnamed: D2.1, Q4.2, Q5.1
unnamed: D2.2, Q4.1, R6.1, TP10.1, U2.2
unnamed: D3.2, L2.2, Q5.2
unnamed: D4.1, R11.1
unnamed: LED1.1, LED2.2
unnamed: LED1.2, Q11.3, R4.2, TP28.1
unnamed: LED2.1, LED3.2
unnamed: LED3.1, LED4.2
unnamed: LED4.1, LED5.2
unnamed: LED5.1, LED6.2
unnamed: N1.1, R30.2
unnamed: N2.1, R32.2
unnamed: N2.13, R33.1
unnamed: N3.1, R35.2
unnamed: N4.1, R37.2
unnamed: N4.13, R38.1
unnamed: N5.1, R40.2
unnamed: N6.1, R42.2
unnamed: NE1.1, R43.1
unnamed: NE2.1, R45.1
unnamed: Q1.1, Q2.1, R1.2, TP8.1, U1.1, U1.8
unnamed: Q1.2, Q2.2, Q3.1
unnamed: Q8.1, R26.2
unnamed: Q8.3, R23.2, TP23.1, U5.27
unnamed: Q9.1, R27.2
unnamed: Q9.3, R24.2, TP21.1, U5.23, U6.23
unnamed: Q10.1, R28.2
unnamed: Q10.3, R25.2, R48.1, R50.1, TP22.1
unnamed: Q11.1, R5.2
unnamed: R7.2, R8.1
unnamed: R10.1, RV2.3
unnamed: R14.1, R15.1, RV3.2, TP15.1
unnamed: R17.2, U4.3
unnamed: R18.2, SW4.1, U4.1
unnamed: R29.2, R30.1
unnamed: R31.2, R32.1
unnamed: R34.2, R35.1
unnamed: R36.2, R37.1
unnamed: R39.2, R40.1
unnamed: R41.2, R42.1
unnamed: R43.2, R44.1
unnamed: R45.2, R46.1
unnamed: R47.2, U5.26
unnamed: R48.2, U5.28
unnamed: R49.2, U6.26
unnamed: R50.2, U6.28
unnamed: TP24.1, U5.18, U6.27
VCC: C5.1, C12.1, C22.1, C23.1, L1.2, R2.1, R5.1, R12.1, R13.1, R17.1, R18.1, R19.1, R21.1, R22.1, R26.1, R27.1, R28.1, RV1.3, RV3.1, TP4.1, U3.8, U4.8
