gotlaufs/rtu-nixie-clock/Software/include/pin_map.h

/**
 * Pin map
 */
#ifndef PIN_MAP_H_
#define PIN_MAP_H_

/* Pins */
#define LED_ONBOARD 2
#define LED         15

#define HV_DATA     16
#define HV_CLK      4
#define HV_BLANK    5

#define SW_1        0
#define SW_2        12  // This also doubles as data pin for WS2812
#define SW_3        13

#define SDA         14
#define SCL         2

#define WS_DATA     12 // Also doubles as SW_1

#endif // PIN_MAP_H_
