gotlaufs/rtu-nixie-clock/Software/app/hv_ic.cpp

#include "hv_ic.h"
#include "pin_map.h"

#include <SmingCore/SmingCore.h>

#include <cstdint>

int HV_BRIGHTNESS_LEVEL = 100;
enum hv_status_enum HV_STATUS = HV_NORMAL;

void hv_blank_pwm(void *arg){
    static int counter = 0;

    if (HV_STATUS == HV_NORMAL){
        if (counter <= HV_BRIGHTNESS_LEVEL){
            // HV_BLANK
            // Turn tubes ON (blank is active LOW)
            digitalWrite(HV_BLANK, 0);
        }
        else{
            // Turn tubes OFF (blank is active LOW)
            digitalWrite(HV_BLANK, 1);
        }
    }
    else{
        digitalWrite(HV_BLANK, 1);
    }

    counter++;

    if (counter > 100){
        counter = 0;
    }
}

void hv_push_byte(uint8_t data){
    // uint8_t mask = 0x01;

    // // Push out LSB first
    // // HV_DATA is on GPIO16
    // while (mask){
    //     if (data & mask){
    //         gpio16_output_set(1);
    //     }
    //     else{
    //         gpio16_output_set(0);
    //     }

    //     // Make a clock edge. Data is read on CLK H->L
    //     gpio_output_set(0, (1 << HV_CLK), 0, 0);
    //     // Shift reg operates @max 8 MHz, add some delay
    //     os_delay_us(1);
    //     gpio_output_set((1 << HV_CLK), 0, 0, 0);

    //     mask = mask << 1;
    // }
    uint8_t mask = 0x80;

    // TODO: Remove this
    digitalWrite(HV_BLANK, 0);

    // Push out MSB first
    // HV_DATA is on GPIO16
    while (mask){
        if (data & mask){
            digitalWrite(HV_DATA, 1);
        }
        else{
            digitalWrite(HV_DATA, 0);
        }
        // Make a clock edge. Data is read on CLK H->L
        digitalWrite(HV_CLK, 1);
        // Shift reg operates @max 8 MHz, add some delay
        delayMicroseconds(1);
        digitalWrite(HV_CLK, 0);
        delayMicroseconds(1);

        mask = mask >> 1;
    }

    // TODO: Remove this
    digitalWrite(HV_BLANK, 1);
}
