gotlaufs/rtu-nixie-clock/Software/include/display.h

/*
 * Various high level functions for controlling Nixie Tube display
 *
 */

#ifndef _DISPLAY_H_
#define _DISPLAY_H_

// Directly show current system time data
void show_time_simple(void);

#endif //
