gotlaufs/rtu-nixie-clock/Software/include/build_time.h

/*
 *  Macros to determine build time for file
 */
#ifndef _BUILD_TIME_H_
#define _BUILD_TIME_H_

#define COMPUTE_BUILD_HOUR ((__TIME__[0] - '0') * 10 + __TIME__[1] - '0')
#define COMPUTE_BUILD_MIN  ((__TIME__[3] - '0') * 10 + __TIME__[4] - '0')
#define COMPUTE_BUILD_SEC  ((__TIME__[6] - '0') * 10 + __TIME__[7] - '0')


#define BUILD_DATE_IS_BAD (__DATE__[0] == '?')

#define BUILD_YEAR  ((BUILD_DATE_IS_BAD) ? 99 : COMPUTE_BUILD_YEAR)
#define BUILD_MONTH ((BUILD_DATE_IS_BAD) ? 99 : COMPUTE_BUILD_MONTH)
#define BUILD_DAY   ((BUILD_DATE_IS_BAD) ? 99 : COMPUTE_BUILD_DAY)

#define BUILD_TIME_IS_BAD (__TIME__[0] == '?')

#define BUILD_HOUR  ((BUILD_TIME_IS_BAD) ? 99 :  COMPUTE_BUILD_HOUR)
#define BUILD_MIN   ((BUILD_TIME_IS_BAD) ? 99 :  COMPUTE_BUILD_MIN)
#define BUILD_SEC   ((BUILD_TIME_IS_BAD) ? 99 :  COMPUTE_BUILD_SEC)

#endif // _BUILD_TIME_H_
