gotlaufs/rtu-nixie-clock/Software/include/defines.h

/*
 * Various defines
 */
#ifndef _DEFINES_H_
#define  _DEFINES_H_

/* Pins */
#define LED_ONBOARD 2
#define LED         15

#define HV_DATA     16
#define HV_CLK      4
#define HV_BLANK    5

#define SW_1        12  // This also doubles as data pin for WS2812
#define SW_2        13
#define SW_3        0

#define SDA         2
#define SCL         14

#define WS_DATA     12 // Also doubles as SW_1

#endif // _DEFINES_H_
