gotlaufs/rtu-nixie-clock/Software/app/utils.cpp

// Various utility functions
#include "utils.h"
#include <SmingCore/SmingCore.h>

namespace Utils
{
uint32_t randomInRange(uint32_t start, uint32_t end)
{
    // Generate a random number from 0 to 0xFFFFFFFF
    uint32_t rand;
    os_get_random(reinterpret_cast<uint8_t *>(&rand), sizeof(rand));

    // Move it into the required range
    uint32_t range = end - start;
    uint64_t ret = (static_cast<uint64_t>(rand) * range) / 0xFFFFFFFF;

    // Prevent integer error
    if(ret == range)
    {
        ret--;
    }

    ret += start;
    return ret;
}
}
