gotlaufs/rtu-nixie-clock/Software/include/utils.h

// Various utility functions
#ifndef UTILS_H_
#define UTILS_H_

#include <cstdint>

namespace Utils
{
    // Generate a random number in range [start:end)
    uint32_t randomInRange(uint32_t start, uint32_t end);
}

#endif
