gotlaufs/rtu-nixie-clock/(commit log)

2019-01-02 First commit. Add everything
    [BOM_esp_nixie_clock.odf.ods, Order_2017_11_21.ods, esp12.sch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]
2019-01-17 Add MCP7940 files from other project and begin experimenting with I2C
2019-01-30 Figure out how to run RTC correctly
    [application.cpp, display.cpp, mcp7940.cpp, nixie_clock.cpp, nixie_clock.h]
2019-01-30 Fix errors that prevent compilation
    [application.cpp, display.cpp, nixie_clock.cpp]
2019-01-31 Fix wrong RTC initialization
    [nixie_clock.cpp]
2019-01-31 Experiments with Interrupts. SW3 does not seem to be working
2019-02-04 Start making Button class for event detection
2019-02-10 Add simple serial button faker
2019-02-16 Enable numbers 3&4 on Nixie Tube N5. Seems like the electrical short is gone
    [nixie_driver.cpp]
2019-02-17 Use Button class for all tactile switches
2019-02-19 Fix flakiness in setting time to external RTC
    [mcp7940.cpp, set_time_state.cpp]
2019-12-01 Add tube saver state
2019-12-01 Mostly finish logic for tube saver and make it compile
2019-12-01 Run tube saver every hour
2019-12-01 Show sceensaver when the device boots
2019-12-01 Remove debug prints and fix annoying zeros
    [show_time_state.cpp, tube_saver_state.cpp]
